yuansco/USB-Type-C-Power-Meter/image/demo.png

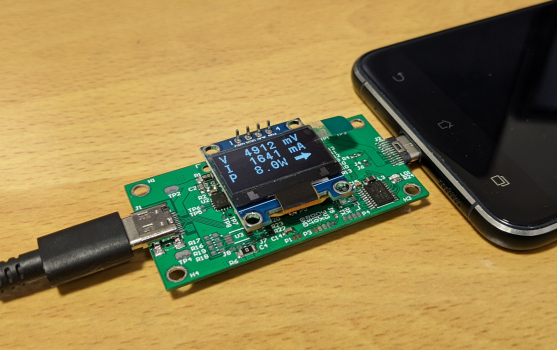
image/demo.png
