yuansco/USB-Type-C-Power-Meter/image/Block Diagram SKU-1.png

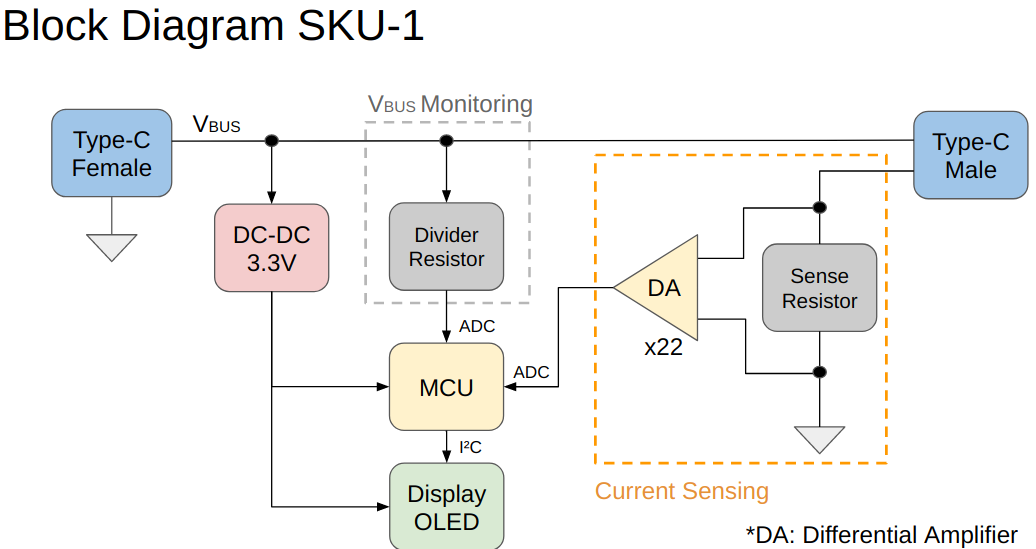
image/Block Diagram SKU-1.png
