yuansco/USB-Type-C-Power-Meter/image/Block Diagram SKU-2.png

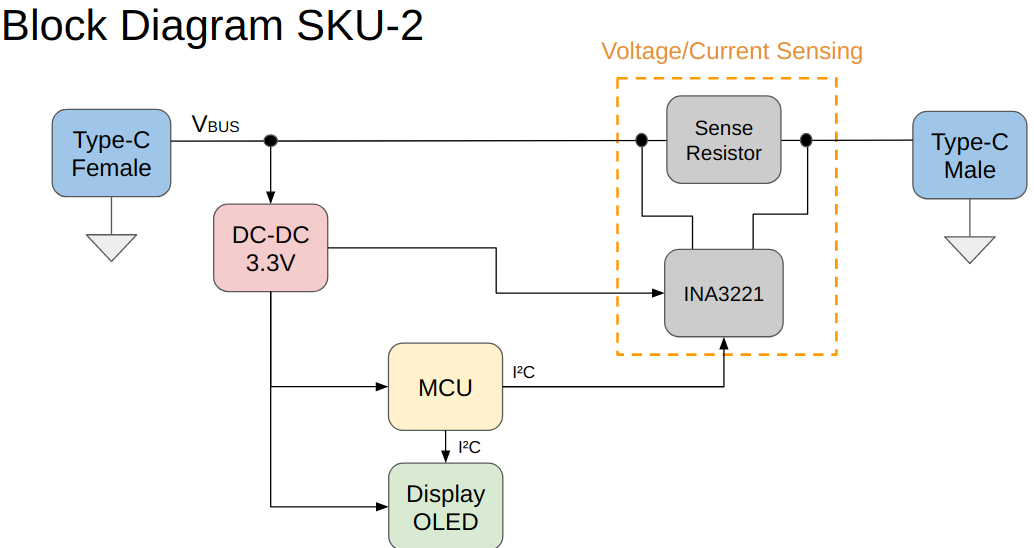
image/Block Diagram SKU-2.png
