yuansco/USB-Type-C-Power-Meter/hardware/USB Type-C Power Meter_0829.pdf

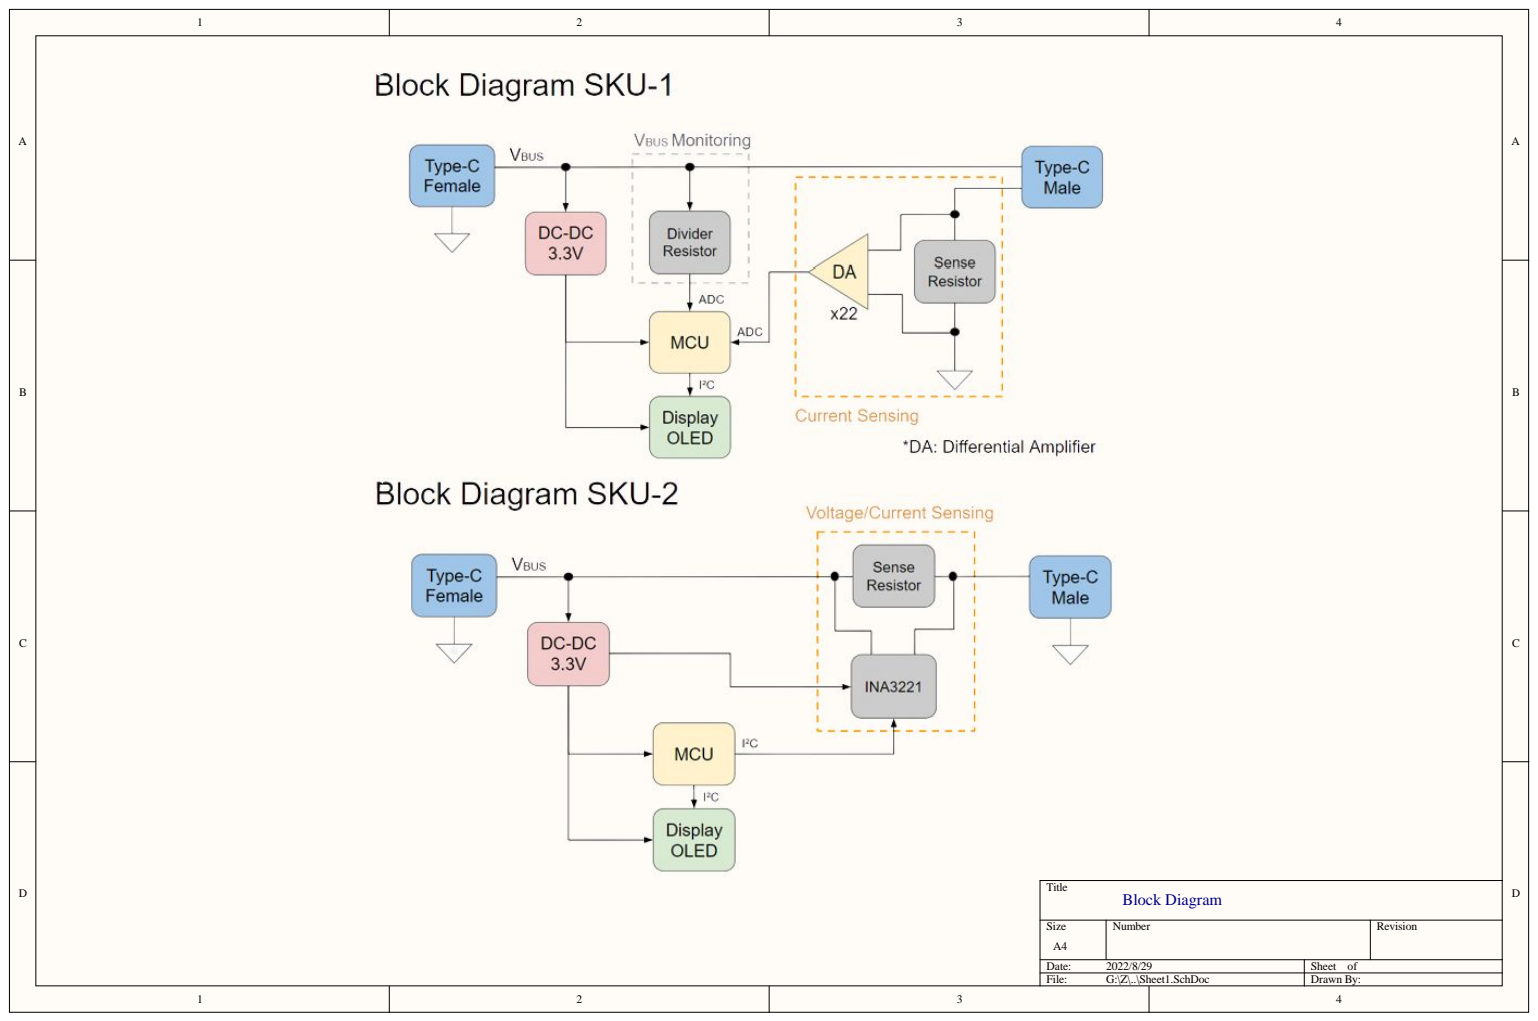
[picture p4: page 1]

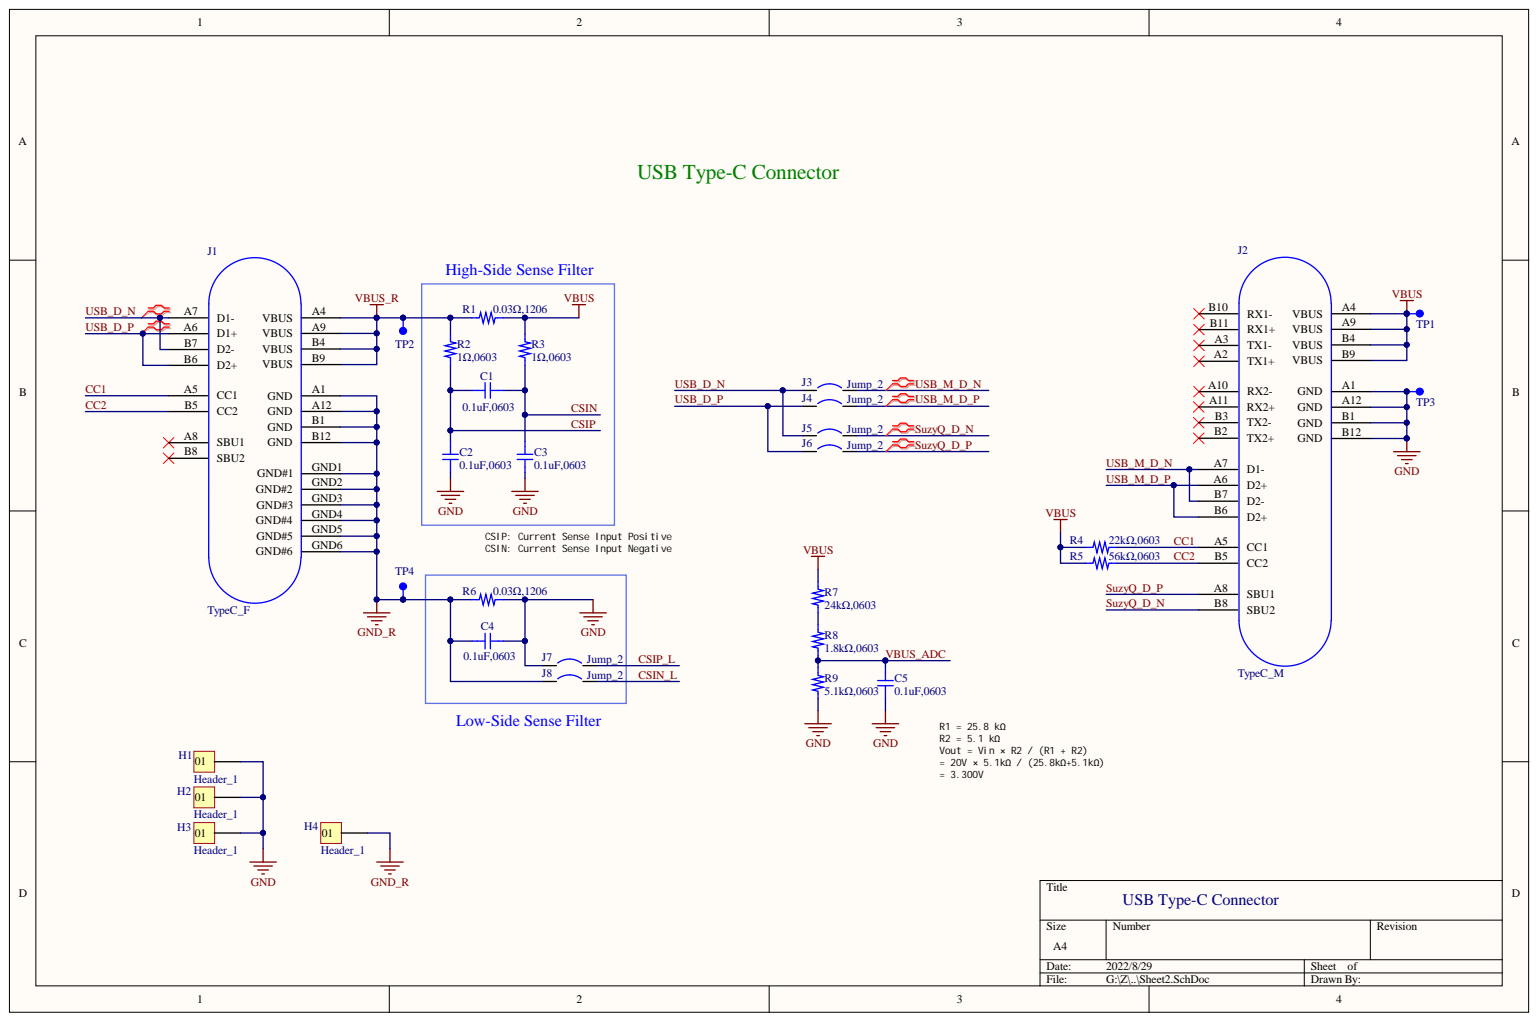
[picture p5: page 2]

High-Side Sense Filte

CSIP: Current Sense Input Positive
CSIN: Current Sense Input Negative

Low-Side Sense Filter

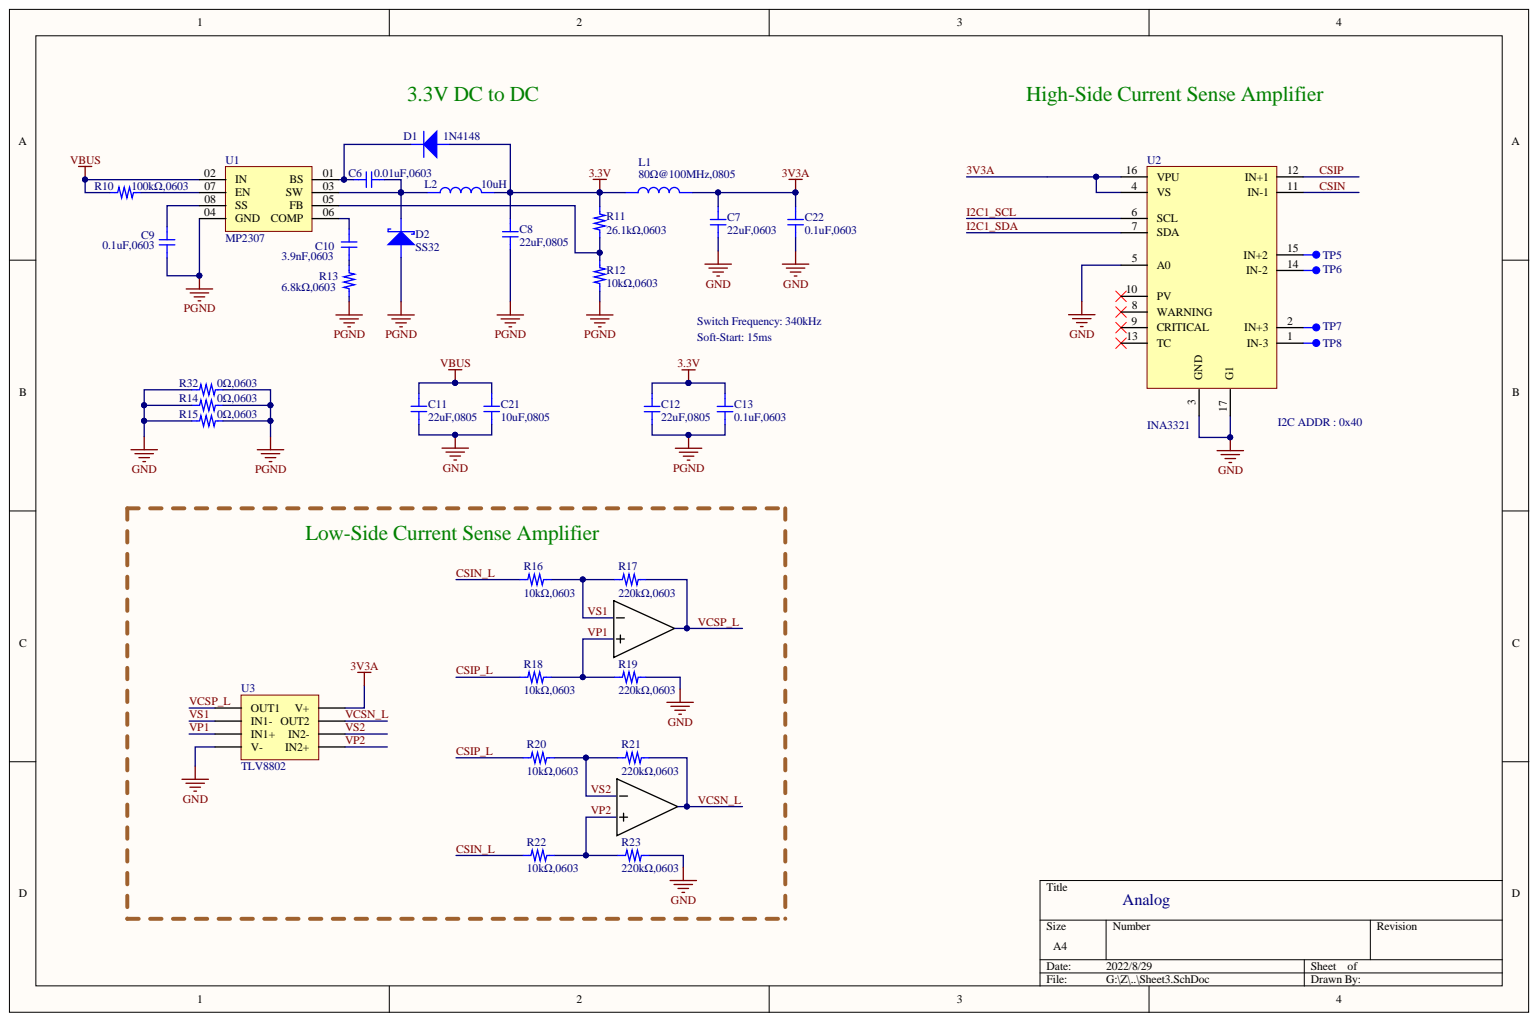
[picture p6: page 3]

High-Side Current Sense Amplifier

Low-Side Current Sense Amplifier

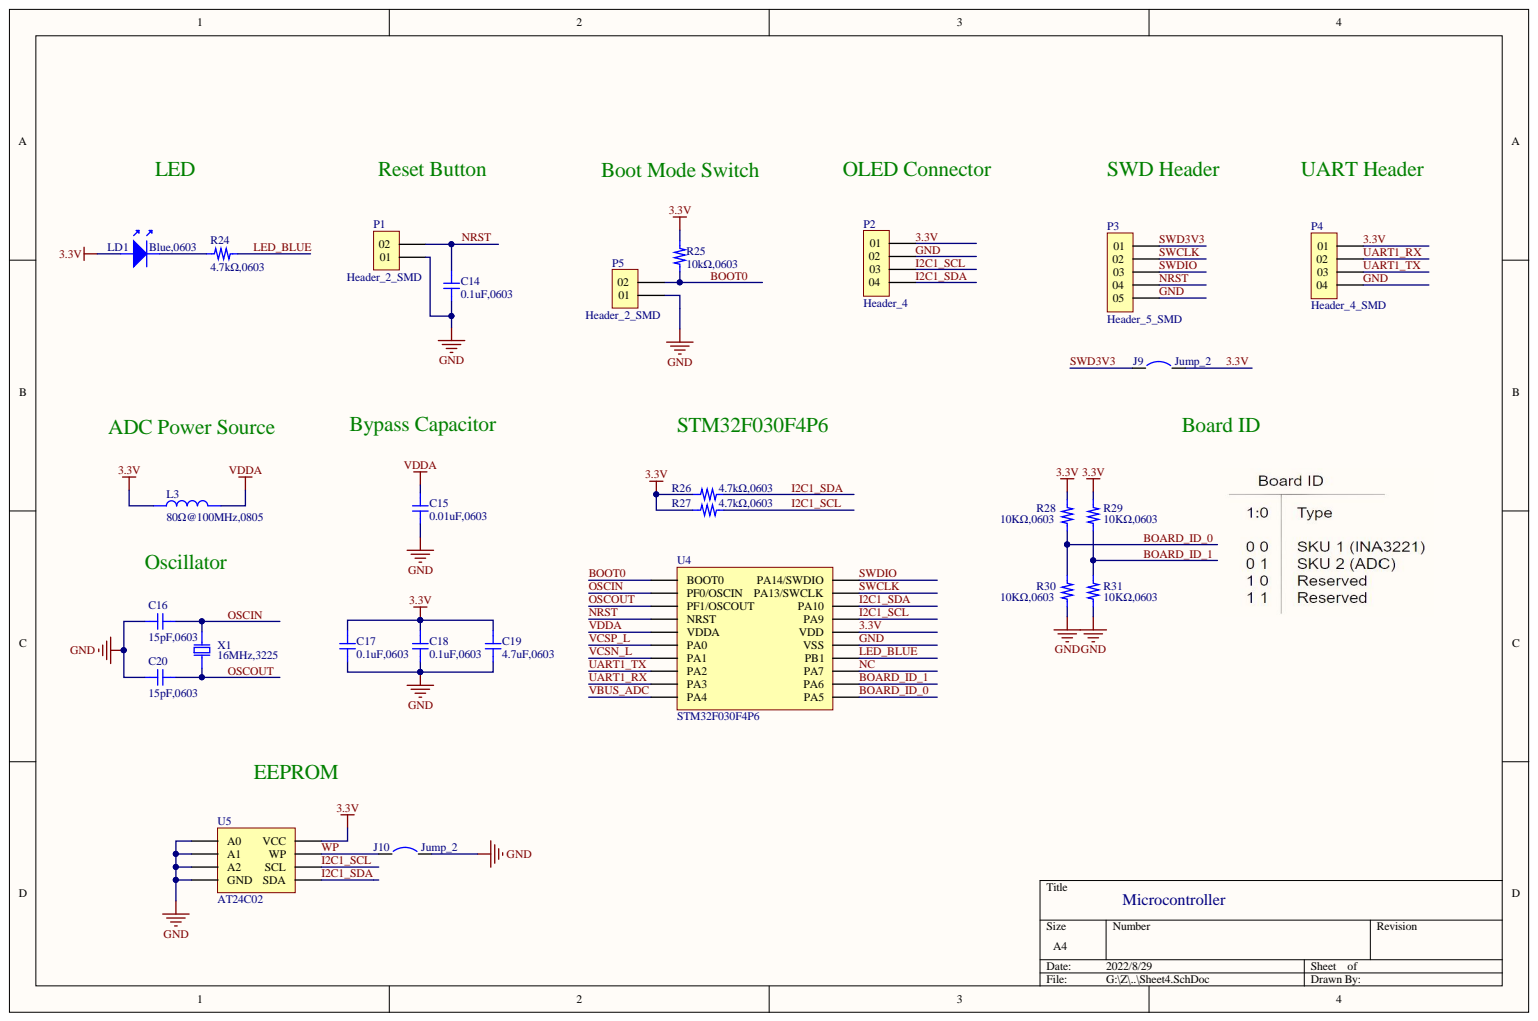
[picture p7: page 4]
