yuansco/USB-Type-C-Power-Meter/firmware/Core/Src/main.c

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
/* Includes ------------------------------------------------------------------*/
#include "main.h"

/* USER CODE BEGIN Includes */
#include "board.h"
#include "light_rcc_init.h"
/* USER CODE END Includes */

/* USER CODE BEGIN PM */

I2C_HandleTypeDef hi2c1;

#if defined(UART_DEBUG) && !defined(UART_DEBUG_GPIO)
UART_HandleTypeDef huart1;
#endif

#if !defined(FIXED_SKUID) || (SKUID == SKUID_1)
ADC_HandleTypeDef hadc;
#endif

#if 0
/* USER CODE END PM */

ADC_HandleTypeDef hadc;

I2C_HandleTypeDef hi2c1;

UART_HandleTypeDef huart1;

/* USER CODE BEGIN PV */
#endif
/* USER CODE END PV */

void SystemClock_Config(void);
static void MX_GPIO_Init(void);
static void MX_ADC_Init(void);
static void MX_I2C1_Init(void);
static void MX_USART1_UART_Init(void);
/* USER CODE BEGIN 0 */
#include <stdio.h>
#include <string.h>
/* USER CODE END 0 */

/**
  * @brief  The application entry point.
  * @retval int
  */
int main(void)
{
  /* MCU Configuration--------------------------------------------------------*/

  /* Reset of all peripherals, Initializes the Flash interface and the Systick. */
  HAL_Init();

  /* USER CODE BEGIN Init */
#ifndef CONFIG_LIGHT_RCC_INIT
  /* USER CODE END Init */

  /* Configure the system clock */
  SystemClock_Config();

  /* USER CODE BEGIN SysInit */
#else
  Light_SystemClock_Config();
#endif
  /* USER CODE END SysInit */

  /* Initialize all configured peripherals */
  MX_GPIO_Init();
  MX_ADC_Init();
  MX_I2C1_Init();
  MX_USART1_UART_Init();
  /* USER CODE BEGIN 2 */

  BOARD_Init();
  PRINTF("Init Done\r\n");

  int tick_loop = HAL_GetTick();

#ifdef CONFIG_LED_NORMAL
  int tick_led = HAL_GetTick();
#endif
  /* USER CODE END 2 */

  /* Infinite loop */
  /* USER CODE BEGIN WHILE */
  while (1)
  {
    /* USER CODE END WHILE */

    /* USER CODE BEGIN 3 */
    if((HAL_GetTick() - tick_loop) >= CONFIG_BOARD_LOOP_TIME_MS) {
      tick_loop = HAL_GetTick();
      BOARD_Loop();
    }

#ifdef CONFIG_LED_NORMAL
    if((HAL_GetTick() - tick_led) >= CONFIG_LED_NORMAL_BLINK_MS) {
      tick_led = HAL_GetTick();
      HAL_GPIO_TogglePin(LED_BLUE_GPIO_Port, LED_BLUE_Pin);
    }
#endif

  }
  /* USER CODE END 3 */
}

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
