yuansco/USB-Type-C-Power-Meter/firmware/Core/Inc/main.h

#define VCSP_L_Pin GPIO_PIN_0
#define VCSP_L_GPIO_Port GPIOA
#define VCSN_L_Pin GPIO_PIN_1
#define VCSN_L_GPIO_Port GPIOA
#define VBUS_ADC_Pin GPIO_PIN_4
#define VBUS_ADC_GPIO_Port GPIOA
#define BOARD_ID_0_Pin GPIO_PIN_5
#define BOARD_ID_0_GPIO_Port GPIOA
#define BOARD_ID_1_Pin GPIO_PIN_6
#define BOARD_ID_1_GPIO_Port GPIOA
#define NC_Pin GPIO_PIN_7
#define NC_Pin_Port GPIOA
#define LED_BLUE_Pin GPIO_PIN_1
#define LED_BLUE_GPIO_Port GPIOB
