yuansco/USB-Type-C-Power-Meter/firmware/Core/Driver/ina3221/ina3221.c

// INA3221 - Ti current sense amplifiers

#include "ina3221.h"


#ifdef INA3221_DEBUG
#define CPRINTF(format, args...) PRINTF("INA3221: " format, ##args)
#else
#define CPRINTF(format, args...) 
#endif


static int ina3221_set_reg_pointer(uint8_t reg)
{
	uint8_t re;

	re = HAL_I2C_Master_Transmit(&hi2c1, (INA3221_I2C_ADDR << 1),
						&reg, sizeof(reg), 1000);

	if (re != HAL_OK)
		CPRINTF("setup reg pointer fail! (%d)", re);

	return re;
}

static int ina3221_read16(uint16_t reg, uint16_t *data)
{
	int re;
	uint16_t val;

	ina3221_set_reg_pointer(reg);

	re = HAL_I2C_Master_Receive(&hi2c1, (INA3221_I2C_ADDR << 1),
					(uint8_t *) &val, sizeof(val), 1000);

	if (re != HAL_OK) {
		CPRINTF("read16 reg:0x%02x fail!", reg);
		return re;
	}

        *data =  (val >> 8) | ((val & 0xff) << 8);
        return 0;
}

static int ina3221_write16(uint16_t reg, uint16_t data)
{
	int re;
	uint16_t val = (data >> 8) | ((data & 0xff) << 8);

	ina3221_set_reg_pointer(reg);

	re = HAL_I2C_Master_Transmit(&hi2c1, (INA3221_I2C_ADDR << 1),
						(uint8_t*) &val, sizeof(val), 1000);

	if (re)
		CPRINTF("write16 reg:0x%02x data:0x%04x fail!", reg, data);

	return re;
}

int ina3221_gat_data(int ch, int *shunt_volt, int *bus_volt)
{
	int re;
	uint16_t volt;
	uint16_t shunt_volt_reg ,bus_volt_reg;

	shunt_volt_reg = INA3221_REG_SHUNT_VOLT + (2*(ch-1));
	bus_volt_reg = shunt_volt_reg + 1;

	re = ina3221_read16(shunt_volt_reg, &volt);

	if (re) {
		return 1;
	}
	CPRINTF("read16 SHUNT_VOLT 0x%02x (%d)\r\n", volt, volt);

	*shunt_volt = INA3221_SHUNT_UV((int)volt);

	re = ina3221_read16(bus_volt_reg, &volt);

	if (re) {
		return 1;
	}

	CPRINTF("read16 BUS_VOLT 0x%02x (%d)\r\n", volt, volt);

	*bus_volt = INA3221_BUS_MV(volt);

	return re;
}

int ina3221_reset(void)
{
	uint16_t config = INA3221_CONFIG_REG | INA3221_REG_RST;

	CPRINTF("reset\r\n");

	return ina3221_write16(INA3221_REG_CONFIG, config);
}

/**
 * return 0 ,if ina3221 no respond
 * return 1 ,if ina3221 exist
 */
int is_ina3221_ready(void)
{
	return !(HAL_I2C_IsDeviceReady(&hi2c1, (INA3221_I2C_ADDR << 1), 3, 10));
}

int ina3221_init(void)
{
	CPRINTF("init\r\n");

	if (!is_ina3221_ready()) {
		CPRINTF("Can not found ina3221!\r\n");
		return 1;
	}

	ina3221_reset();

	HAL_Delay(10);

	return ina3221_write16(INA3221_REG_CONFIG, INA3221_CONFIG_REG);
}
